thalesrochas/atlas-scanner/Placas/placa.png

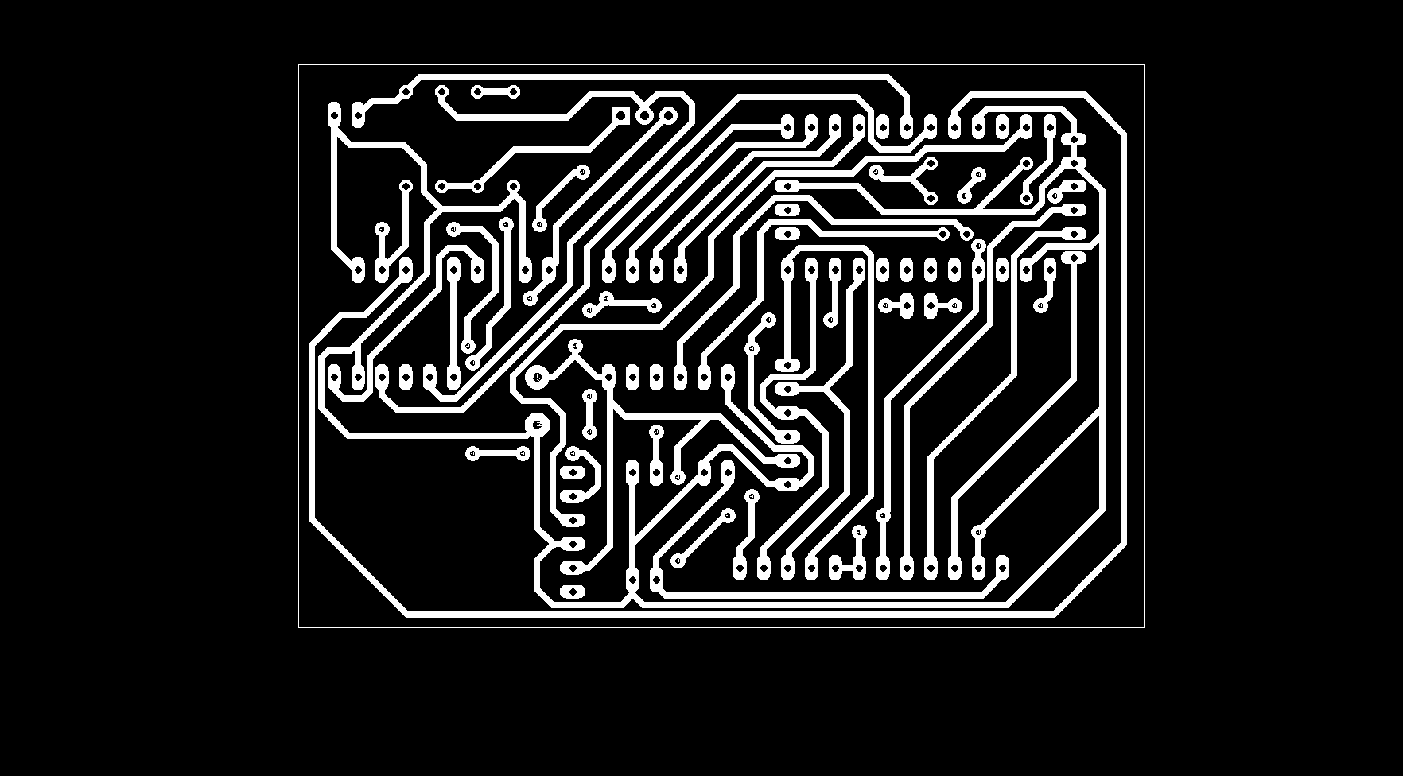
Placas/placa.png
