thalesrochas/atlas-scanner/Peças/Gear/engok.stl

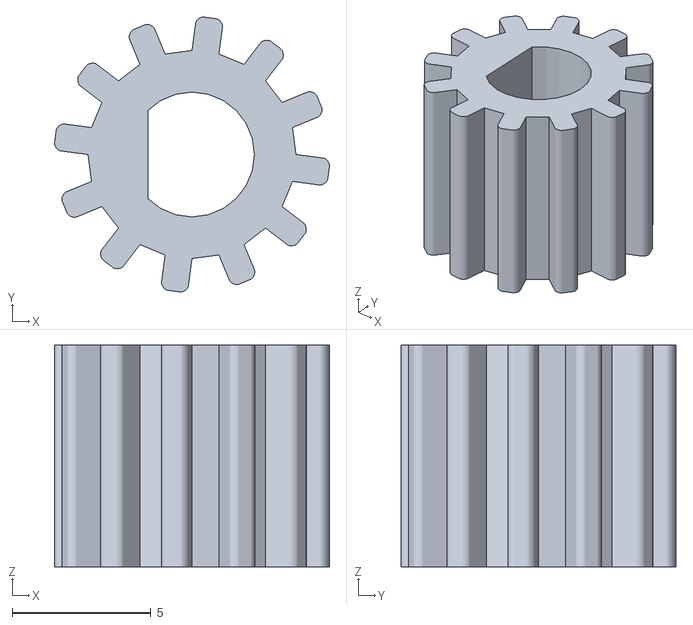
[picture p23: CAD file, 2019-03-19]
Peças/Gear/engok.stl
9.91 x 9.91 x 8.00
