thalesrochas/atlas-scanner/Peças/Lidar Support/lidar_lens_cap0.stl

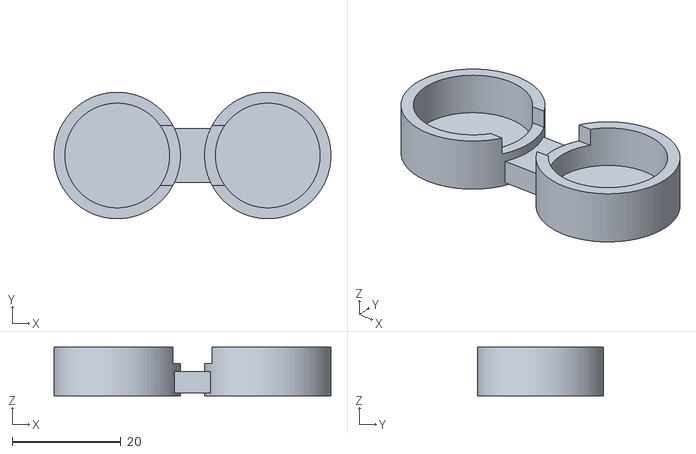
[picture p24: CAD file, 2019-03-19]
Peças/Lidar Support/lidar_lens_cap0.stl
51.0 x 23.3 x 9.00
