thalesrochas/atlas-scanner/Peças/NewGear/gear17.stl

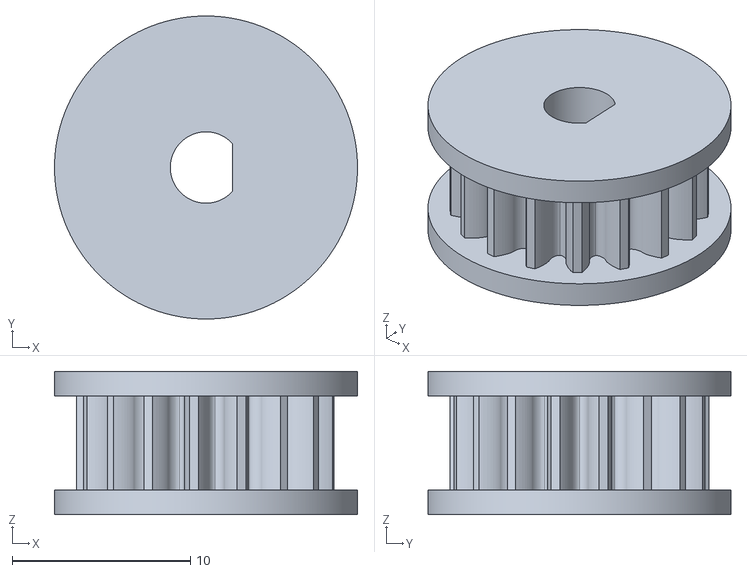
[picture p25: CAD file, 2019-03-19]
Peças/NewGear/gear17.stl
17.0 x 17.0 x 8.05
