thalesrochas/atlas-scanner/Peças/Gear/Suport.stl

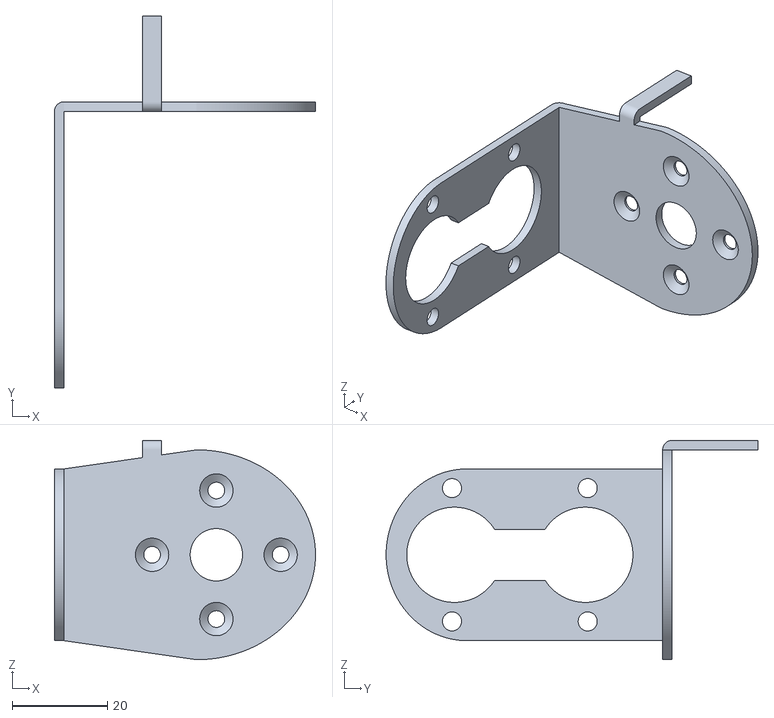
[picture p26: CAD file, 2019-03-19]
Peças/Gear/Suport.stl
54.8 x 78.1 x 46.1
