thalesrochas/atlas-scanner/Peças/Gear/Engrenagem.stl

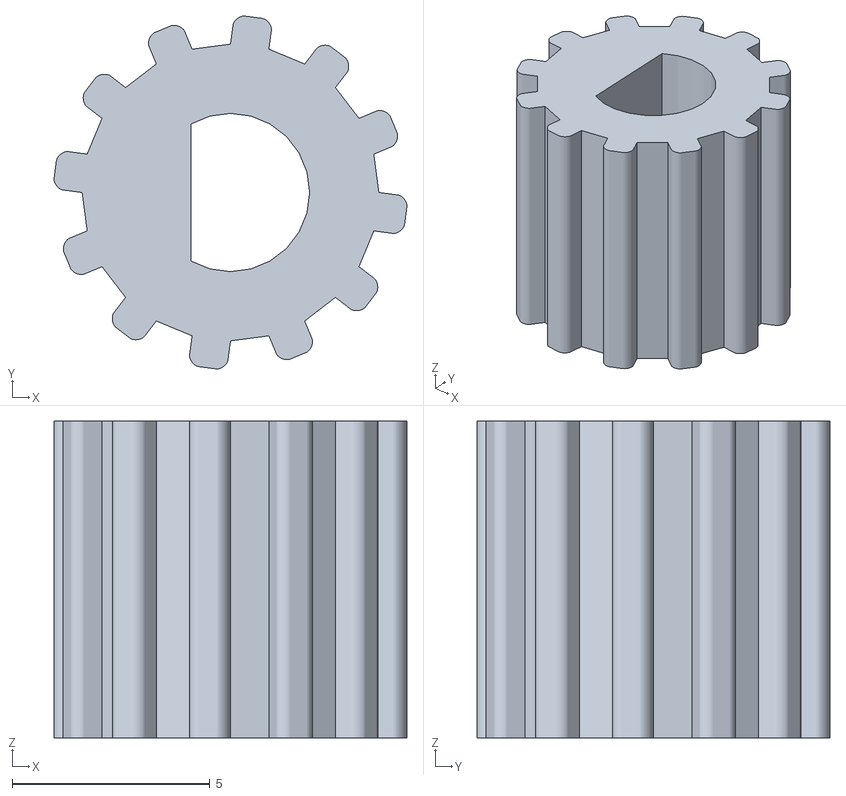
[picture p27: CAD file, 2019-03-19]
Peças/Gear/Engrenagem.stl
8.92 x 8.92 x 8.00
