thalesrochas/atlas-scanner/Peças/Gear/EngrenagemGrande.stl

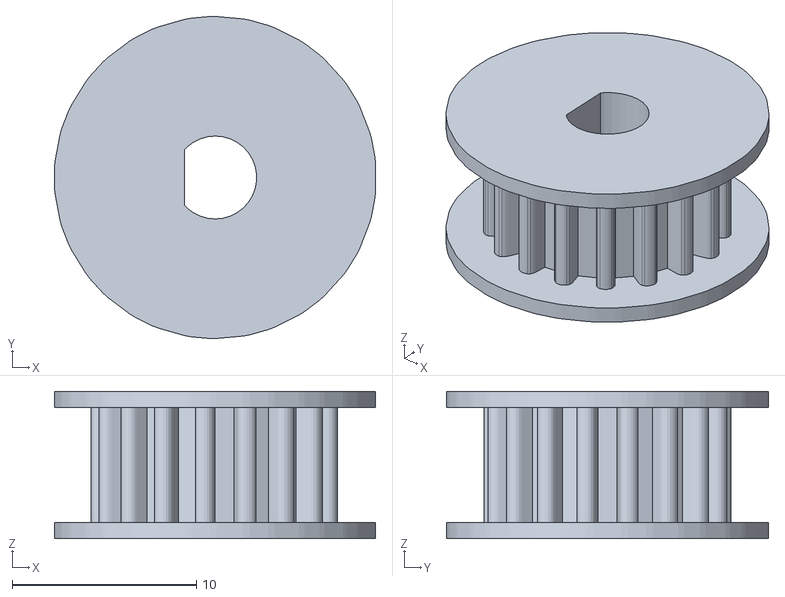
[picture p28: CAD file, 2019-03-19]
Peças/Gear/EngrenagemGrande.stl
17.4 x 17.5 x 8.00
