thalesrochas/atlas-scanner/(list of files, cad)

Other CAD files:
Peças/NewGear/gear17 - 1.1.stl
Peças/Gear/Engrenagem.blend
Peças/Gear/Engrenagem2.blend
Peças/Gear/Engrenagem3.blend
Peças/Gear/EngrenagemGrande.blend
Peças/Gear/Engrenagemok.blend
Peças/Gear/engok.blend
Peças/Gear/test.blend
Peças/Gear/untitled.blend
Peças/Lidar Support/Suport.blend
Peças/NewGear/gear17.2.blend
Peças/NewGear/gear17.blend
