thalesrochas/atlas-scanner/Arquivos de Testes/11.11.19/TESTE.TXT

233	204.48	90.00
251	212.63	90.00
256	214.01	90.00
258	215.40	90.00
262	216.78	90.00
265	218.16	90.00
270	219.39	90.00
274	220.78	90.00
280	222.16	90.00
281	223.55	90.00
283	224.93	90.00
284	226.31	90.00
284	227.70	90.00
284	228.93	90.00
284	230.30	90.00
283	231.69	90.00
284	233.08	90.00
284	234.46	90.00
284	235.69	90.00
286	237.07	90.00
286	238.46	90.00
287	239.84	90.00
285	241.23	90.00
285	242.61	90.00
284	244.00	90.00
281	245.23	90.00
277	246.61	90.00
274	247.99	90.00
270	249.38	90.00
264	252.61	90.00
261	253.84	90.00
260	255.22	90.00
259	256.61	90.00
257	257.84	90.00
255	259.37	90.00
254	260.60	90.00
252	261.99	90.00
250	263.37	90.00
250	264.76	90.00
249	266.14	90.00
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
