thalesrochas/atlas-scanner/Arquivos de Testes/06.11.19/TESTE.TXT

39	115.39	90.00
40	116.76	90.00
39	118.14	90.00
42	119.36	90.00
42	120.59	90.00
40	121.97	90.00
43	123.19	90.00
40	124.42	90.00
44	125.65	90.00
35	127.03	90.00
34	128.25	90.00
32	129.63	90.00
34	130.86	90.00
39	132.24	90.00
33	133.47	90.00
40	134.84	90.00
38	136.07	90.00
38	137.30	90.00
40	138.52	90.00
40	139.75	90.00
38	140.98	90.00
34	142.20	90.00
38	143.28	90.00
43	144.50	90.00
42	145.58	90.00
42	146.80	90.00
42	148.03	90.00
42	149.10	90.00
43	150.33	90.00
47	151.40	90.00
50	152.63	90.00
50	155.54	90.00
49	156.61	90.00
50	157.84	90.00
51	159.07	90.00
51	160.29	90.00
51	161.37	90.00
51	162.59	90.00
52	163.66	90.00
56	164.89	90.00
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
