thalesrochas/atlas-scanner/Arquivos de Testes/06.11.19/TESTE2.TXT

198	148.12	90.00
212	148.18	90.00
215	149.41	90.00
218	150.63	90.00
221	151.86	90.00
224	153.09	90.00
228	154.31	90.00
230	155.54	90.00
234	156.77	90.00
238	157.99	90.00
243	159.07	90.00
249	160.29	90.00
251	161.52	90.00
246	162.75	90.00
240	163.97	90.00
234	165.04	90.00
230	166.27	90.00
227	167.50	90.00
221	168.72	90.00
217	169.95	90.00
213	171.18	90.00
209	172.40	90.00
205	173.63	90.00
202	174.86	90.00
199	176.08	90.00
196	177.16	90.00
193	178.38	90.00
192	179.61	90.00
191	180.83	90.00
186	183.75	90.00
186	184.97	90.00
183	186.05	90.00
182	187.27	90.00
180	188.50	90.00
180	189.73	90.00
179	190.95	90.00
177	192.18	90.00
175	193.40	90.00
174	194.63	90.00
172	195.86	90.00
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
