thalesrochas/atlas-scanner/Arquivos de Testes/13.09.18/TESTEDELAY100.TXT

89	223.64	90.00
82	230.71	90.00
78	232.25	90.00
74	233.93	90.00
66	235.47	90.00
73	237.00	90.00
66	238.53	90.00
77	240.22	90.00
61	241.90	90.00
74	243.44	90.00
73	245.12	90.00
67	246.81	90.00
68	248.50	90.00
60	250.18	90.00
59	251.71	90.00
48	254.17	90.00
64	256.47	90.00
63	257.85	90.00
62	259.07	90.00
62	260.30	90.00
61	261.53	90.00
61	262.75	90.00
61	263.98	90.00
59	265.20	90.00
52	266.43	90.00
52	267.66	90.00
51	268.88	90.00
50	270.11	90.00
51	271.34	90.00
50	272.56	90.00
48	273.79	90.00
58	276.55	90.00
52	278.24	90.00
55	279.77	90.00
57	281.15	90.00
61	282.53	90.00
63	283.75	90.00
63	285.13	90.00
63	286.36	90.00
63	287.74	90.00
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
