thalesrochas/atlas-scanner/Arquivos de Testes/13.09.18/TESTEDELAY1000.TXT

330	0.00	90.00
333	0.00	90.00
334	0.00	90.00
333	0.00	90.00
332	0.00	90.00
332	0.00	90.00
332	0.00	90.00
333	0.00	90.00
333	0.00	90.00
333	0.00	90.00
332	0.00	90.00
333	0.00	90.00
310	0.00	90.00
312	0.00	90.00
310	0.00	90.00
311	0.00	90.00
311	0.00	90.00
311	0.00	90.00
310	0.00	90.00
310	0.00	90.00
311	0.00	90.00
310	0.00	90.00
310	0.00	90.00
312	0.00	90.00
307	0.00	90.00
309	0.00	90.00
309	0.00	90.00
310	0.00	90.00
311	0.00	90.00
311	0.00	90.00
311	0.00	90.00
310	0.00	90.00
310	0.00	90.00
309	0.00	90.00
308	0.00	90.00
308	0.00	90.00
308	0.00	90.00
310	0.00	90.00
311	0.00	90.00
310	0.00	90.00
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
