thalesrochas/atlas-scanner/Arquivos de Testes/13.09.18/TESTEDELAY50.TXT

287	205.99	90.00
328	204.50	90.00
326	205.73	90.00
323	206.95	90.00
321	208.18	90.00
319	209.40	90.00
318	210.63	90.00
316	211.86	90.00
314	213.08	90.00
312	214.31	90.00
312	215.54	90.00
310	216.76	90.00
310	217.99	90.00
310	219.37	90.00
307	220.60	90.00
307	221.82	90.00
307	223.20	90.00
307	224.43	90.00
306	225.65	90.00
306	226.88	90.00
302	228.11	90.00
301	229.33	90.00
301	230.56	90.00
302	231.79	90.00
302	233.01	90.00
303	234.24	90.00
304	235.62	90.00
306	236.84	90.00
306	238.22	90.00
307	241.14	90.00
311	242.36	90.00
315	243.59	90.00
317	244.82	90.00
321	246.04	90.00
319	247.42	90.00
307	248.65	90.00
292	249.88	90.00
277	251.10	90.00
266	252.33	90.00
251	253.55	90.00
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
