thalesrochas/atlas-scanner/Arquivos de Testes/02.08.18/TEST1.TXT

160.00	0.00	180.00
208.00	0.00	180.00
211.00	0.00	180.00
215.00	0.00	180.00
211.00	0.00	180.00
207.00	0.00	180.00
201.00	0.00	180.00
197.00	0.00	180.00
190.00	0.00	180.00
178.00	0.00	180.00
151.00	0.00	180.00
127.00	0.00	180.00
49.00	0.00	180.00
51.00	0.00	180.00
1.00	0.00	180.00
86.00	0.00	180.00
86.00	0.00	180.00
84.00	0.00	180.00
98.00	0.00	180.00
145.00	0.00	180.00
163.00	0.00	180.00
207.00	0.00	180.00
214.00	0.00	180.00
222.00	0.00	180.00
230.00	0.00	180.00
233.00	0.00	180.00
248.00	0.00	180.00
271.00	0.00	180.00
278.00	0.00	180.00
271.00	0.00	180.00
268.00	0.00	180.00
271.00	0.00	180.00
293.00	0.00	180.00
266.00	0.00	180.00
264.00	0.00	180.00
264.00	0.00	180.00
264.00	0.00	180.00
400.00	0.00	180.00
793.00	0.00	180.00
671.00	0.00	180.00
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
