thalesrochas/atlas-scanner/Arquivos de Testes/02.08.18/TEST2.TXT

295	37.54	180.00
231	43.48	180.00
230	44.28	180.00
230	45.24	180.00
229	46.20	180.00
231	47.17	180.00
235	48.13	180.00
239	49.09	180.00
242	50.05	180.00
245	51.02	180.00
249	51.98	180.00
252	52.78	180.00
256	53.74	180.00
260	54.71	180.00
266	55.67	180.00
271	56.63	180.00
275	57.59	180.00
280	58.40	180.00
284	59.36	180.00
287	60.32	180.00
288	61.28	180.00
284	62.25	180.00
281	63.21	180.00
278	64.17	180.00
276	65.13	180.00
273	66.10	180.00
270	67.06	180.00
268	67.86	180.00
266	68.82	180.00
258	71.23	180.00
256	72.19	180.00
254	72.99	180.00
256	73.96	180.00
254	74.76	180.00
252	75.88	180.00
250	76.68	180.00
249	77.65	180.00
248	78.61	180.00
247	79.57	180.00
246	80.53	180.00
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
