thalesrochas/atlas-scanner/Arquivos de Testes/02.08.18/TEST3.TXT

394	221.71	180.00
417	229.57	180.00
461	230.86	180.00
465	232.14	180.00
468	233.42	180.00
471	234.71	180.00
476	235.99	180.00
388	237.43	180.00
365	238.88	180.00
342	240.32	180.00
328	241.76	180.00
310	243.05	180.00
297	244.49	180.00
234	245.78	180.00
231	247.38	180.00
213	249.95	180.00
200	252.19	180.00
201	254.28	180.00
190	256.04	180.00
179	257.49	180.00
191	258.77	180.00
185	260.21	180.00
192	261.50	180.00
194	262.78	180.00
185	264.22	180.00
183	265.51	180.00
187	266.79	180.00
195	269.68	180.00
204	270.96	180.00
214	272.25	180.00
214	273.53	180.00
222	274.81	180.00
227	276.10	180.00
229	277.38	180.00
229	278.66	180.00
227	279.95	180.00
224	281.23	180.00
222	282.67	180.00
220	283.96	180.00
219	285.24	180.00
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
