thalesrochas/atlas-scanner/Arquivos de Testes/02.08.18/TEST4.TXT

182	75.24	180.00
39	83.58	180.00
73	85.99	180.00
133	88.40	180.00
79	89.84	180.00
86	91.28	180.00
110	92.57	180.00
89	94.01	180.00
386	95.61	180.00
377	96.90	180.00
234	98.18	180.00
228	99.30	180.00
224	100.59	180.00
220	101.87	180.00
220	103.16	180.00
219	104.44	180.00
218	105.56	180.00
218	106.84	180.00
217	107.97	180.00
217	109.25	180.00
215	110.53	180.00
215	111.82	180.00
215	112.94	180.00
213	114.22	180.00
212	115.51	180.00
223	116.79	180.00
783	118.24	180.00
679	119.84	180.00
636	123.05	180.00
633	124.33	180.00
567	126.10	180.00
449	127.22	180.00
448	128.50	180.00
430	129.79	180.00
392	131.23	180.00
392	132.67	180.00
393	133.96	180.00
396	135.40	180.00
397	136.84	180.00
398	138.13	180.00
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
