thalesrochas/atlas-scanner/Placas/PlacaV1/placa.pdf

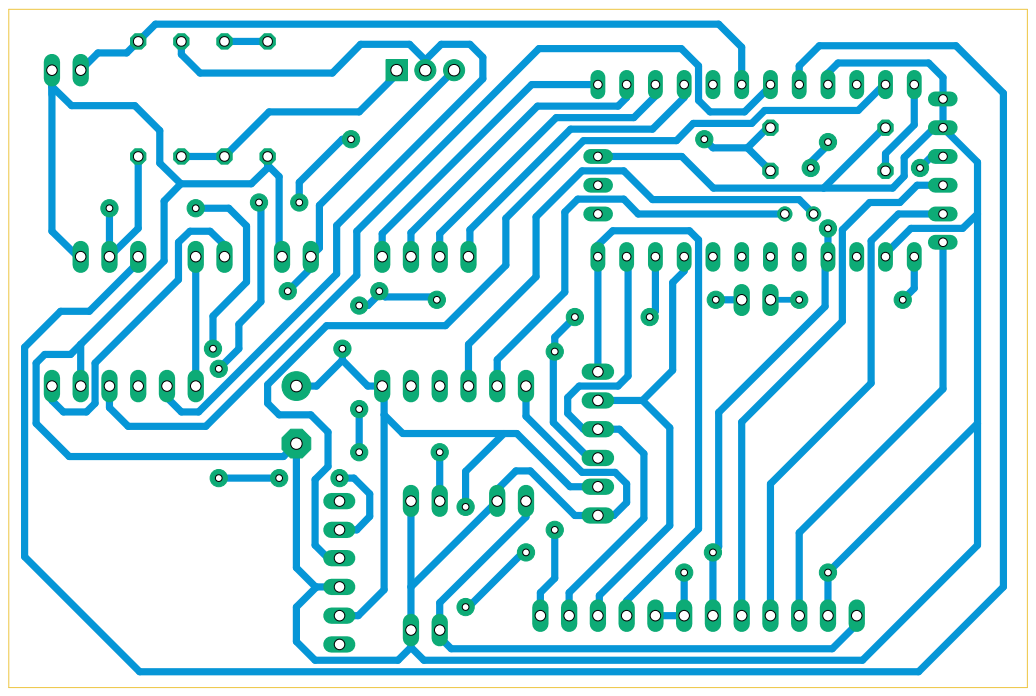
[picture p29: page 1]
