thalesrochas/atlas-scanner/Placas/PlacaV1/placa_black.pdf

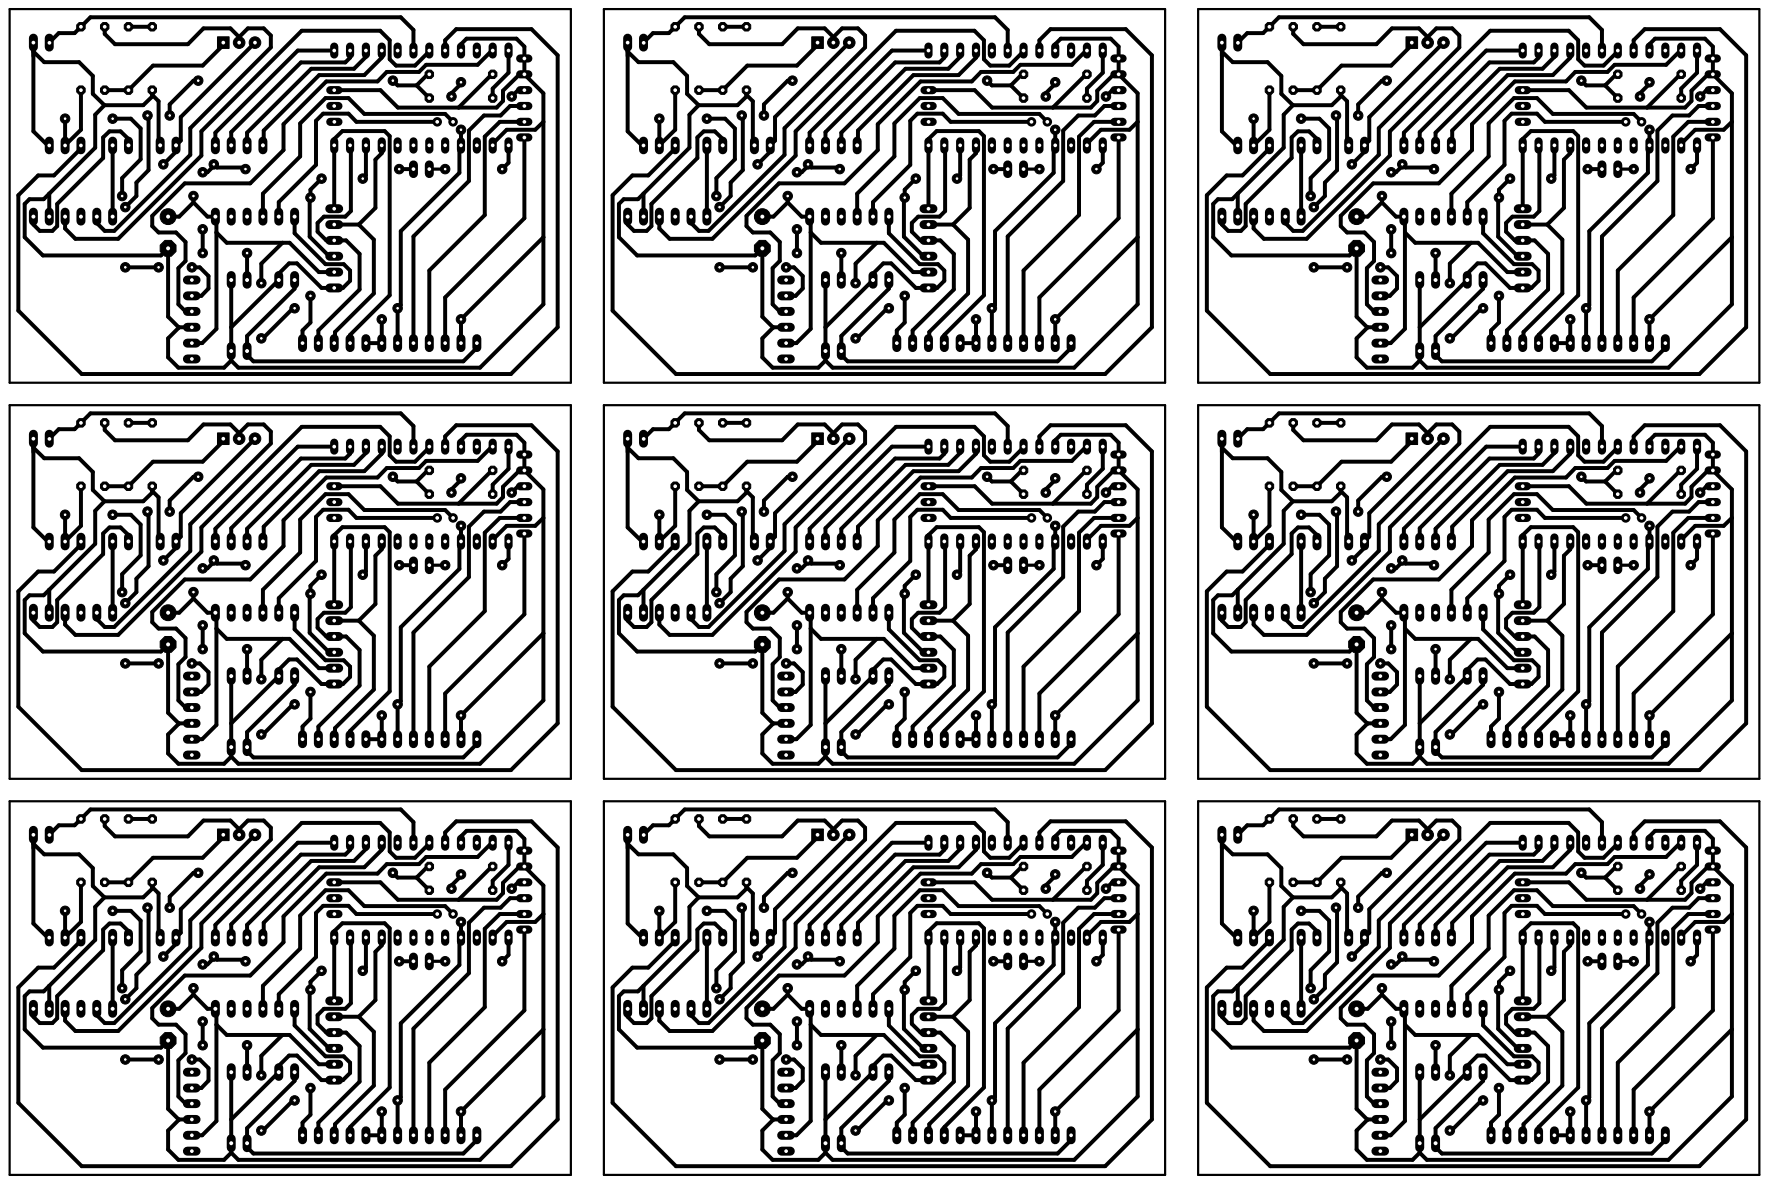
[picture p30: page 1]
