thalesrochas/atlas-scanner/Placas/PlacaV1/Atlas.brd

## EAGLE design Placas/PlacaV1/Atlas.brd (2019-03-19)

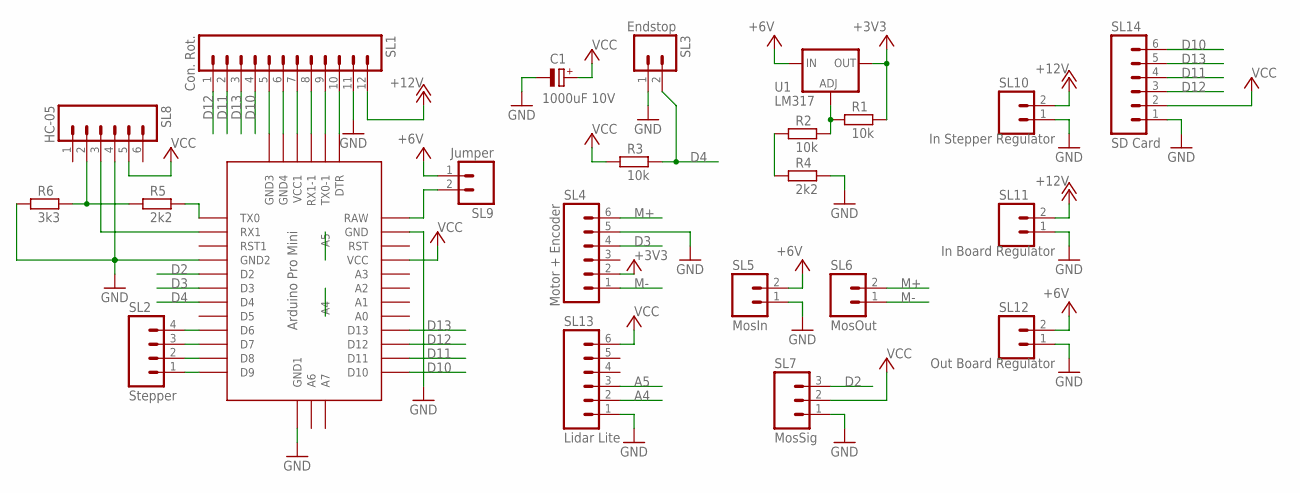
[picture p31: schematic Atlas.sch]

Parts:
C1: 1000uF 10V; E5-10,5
R1, R2, R3: 10k; 0207/10
R4, R5: 2k2; 0207/10
R6: 3k3; 0207/10
SL1: Con. Rot.; 12P
SL2: Stepper; 04P
SL3: Endstop; 02P
SL4: Motor + Encoder; 06P
SL5: MosIn; 02P
SL6: MosOut; 02P
SL7: MosSig; 03P
SL8: HC-05; 06P
SL9: Jumper; 02P
SL10: In Stepper Regulator; 02P
SL11: In Board Regulator; 02P
SL12: Out Board Regulator; 02P
SL13: Lidar Lite; 06P
SL14: SD Card; 06P
U1: LM317; TO220-ADJ
U$1: ABK-PRO-MINI

Connections:
+3V3: R1.2, SL4.2, U1.OUT
+6V: SL5.2, SL9.1, SL12.2, U1.IN
+12V: SL1.12, SL10.2, SL11.2
A4: SL13.2, U$1.A4
A5: SL13.3, U$1.A5
D2: SL7.3, U$1.D2
D3: SL4.4, U$1.D3
D4: R3.2, SL3.2, U$1.D4
D10: SL1.4, SL14.6, U$1.D10
D11: SL1.2, SL14.4, U$1.D11
D12: SL1.1, SL14.3, U$1.D12
D13: SL1.3, SL14.5, U$1.D13
DTR: SL1.10, U$1.DTR
GND: C1.-, R4.2, R6.1, SL1.5, SL1.6, SL1.11, SL3.1, SL4.5, SL5.1, SL7.1, SL8.4, SL10.1, SL11.1, SL12.1, SL13.1, SL14.1, U$1.GND, U$1.GND1 (GND2), U$1.GND2 (GND3), U$1.GND3 (GND4), U$1.GND4 (GND1)
M+: SL4.6, SL6.2
M-: SL4.1, SL6.1
unnamed: R5.2, U$1.TX0
unnamed: SL9.2, U$1.RAW
unnamed: R2.1, R4.1
unnamed: R5.1, R6.2, SL8.2
unnamed: R1.1, R2.2, U1.ADJ
unnamed: SL8.3, U$1.RX1
unnamed: SL2.1, U$1.D9
unnamed: SL2.2, U$1.D8
unnamed: SL2.3, U$1.D7
unnamed: SL2.4, U$1.D6
RX1: SL1.8, U$1.RX1-1
TX0: SL1.9, U$1.TX0-1
VCC: C1.+, R3.1, SL1.7, SL7.2, SL8.5, SL13.6, SL14.2, U$1.VCC, U$1.VCC1

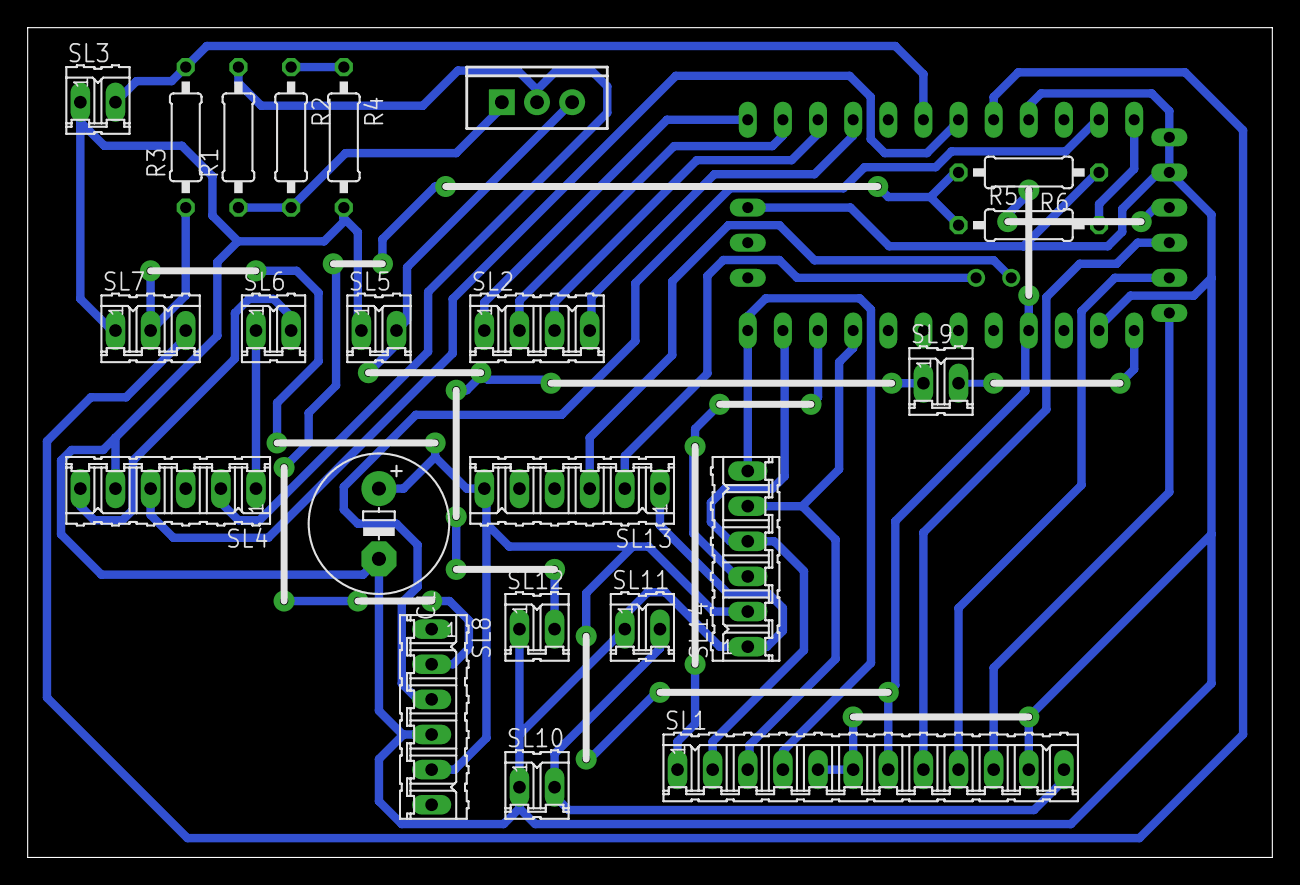
[picture p32: board Atlas.brd from above]

Board: 2 copper layers, 90.0 x 60.0 mm, 23 parts (0 on the bottom side), 29 nets.
