thalesrochas/atlas-scanner/(commit log)

2018-01-05 Adicionado arquivo de testes
2018-07-30 Adicionado arquivo de código principal Atlas.ino.
2018-07-30 Adicionada ação inicial do motor de passo.
2018-07-30 Adicionada integração com o sensor LIDAR. Testes com medição simples de distância.
2018-08-02 Adicionado comentários, constantes, logs e acesso log de captura em cartão de memória
2018-08-02 Adicionado motor com encoder. Interrupção do encoder configurada. Armazenamento de coordenadas no cartão.
2018-08-02 Fix em nome de variável.
    [Atlas.ino]
2018-08-02 Ajustes nas capturas de pontos. Ajustes em cálculos de variáveis.
2018-08-09 Fix em escrita no arquivo
    [Atlas.ino]
2018-08-23 Adicionado movimento no sentido de Phi + cálculo da posição em Phi.
2018-08-23 Adicionados todos os arquivos de testes realizados até o momento.
2018-08-23 Scripts de testes de gráfico em Matlab
2018-11-16 Adicionados arquivos de teste
2018-11-16 Adicionada Placa Versão 1
    [Atlas.brd, Atlas.sch]
2019-03-19 Remoção de arquivos desnecessários
    [Atlas.brd, Atlas.sch]
2019-03-19 Atualização de placas
    [Atlas.brd, Atlas.sch]
2019-03-19 Adicionadas peças
    [Engrenagem.blend, Engrenagem.stl, Engrenagem2.blend, Engrenagem3.blend, EngrenagemGrande.blend, EngrenagemGrande.stl, Engrenagemok.blend, Suport.blend]
2019-11-07 Adicionados diversos arquivos de teste
2019-11-07 Adicionada correção de giro que causava desalinhamento das voltas
2019-11-09 Adicionados novos arquivos de teste
2019-11-14 Ajustes no código e novos arquivos de teste
2019-11-21 Adicionados resultados que serão usados no TCC
